yo3hjv/Yaesu_ATAS_120_Controller/BrdRev1.jpg

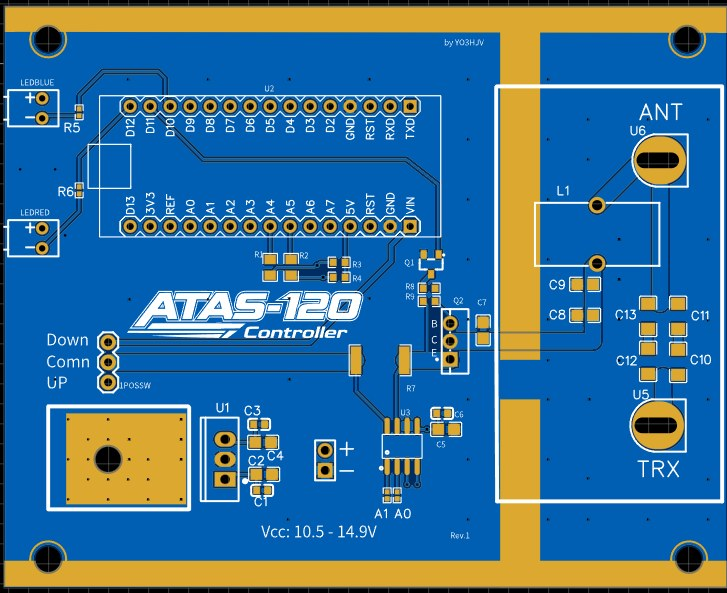
BrdRev1.jpg
