yo3hjv/Yaesu_ATAS_120_Controller/AtasController_bk.jpg

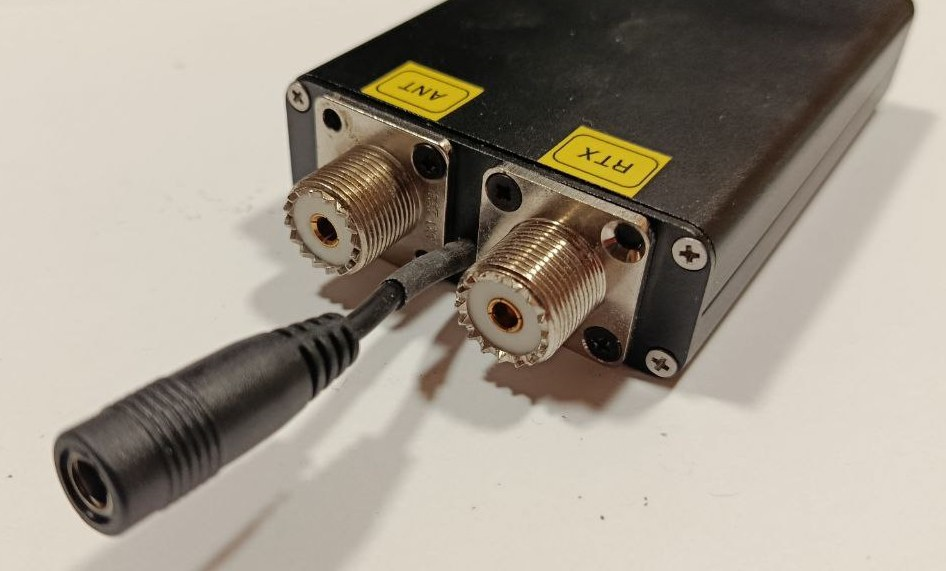
AtasController_bk.jpg
