yo3hjv/Yaesu_ATAS_120_Controller/AtasController_fr.jpg

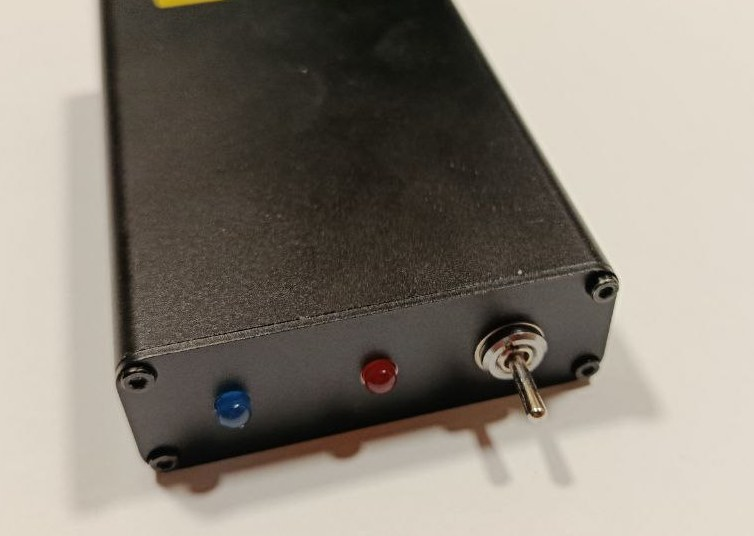
AtasController_fr.jpg
