yo3hjv/Yaesu_ATAS_120_Controller/Schematic_ATAS-120-Controller_2026-03-09.pdf

# U1 Input

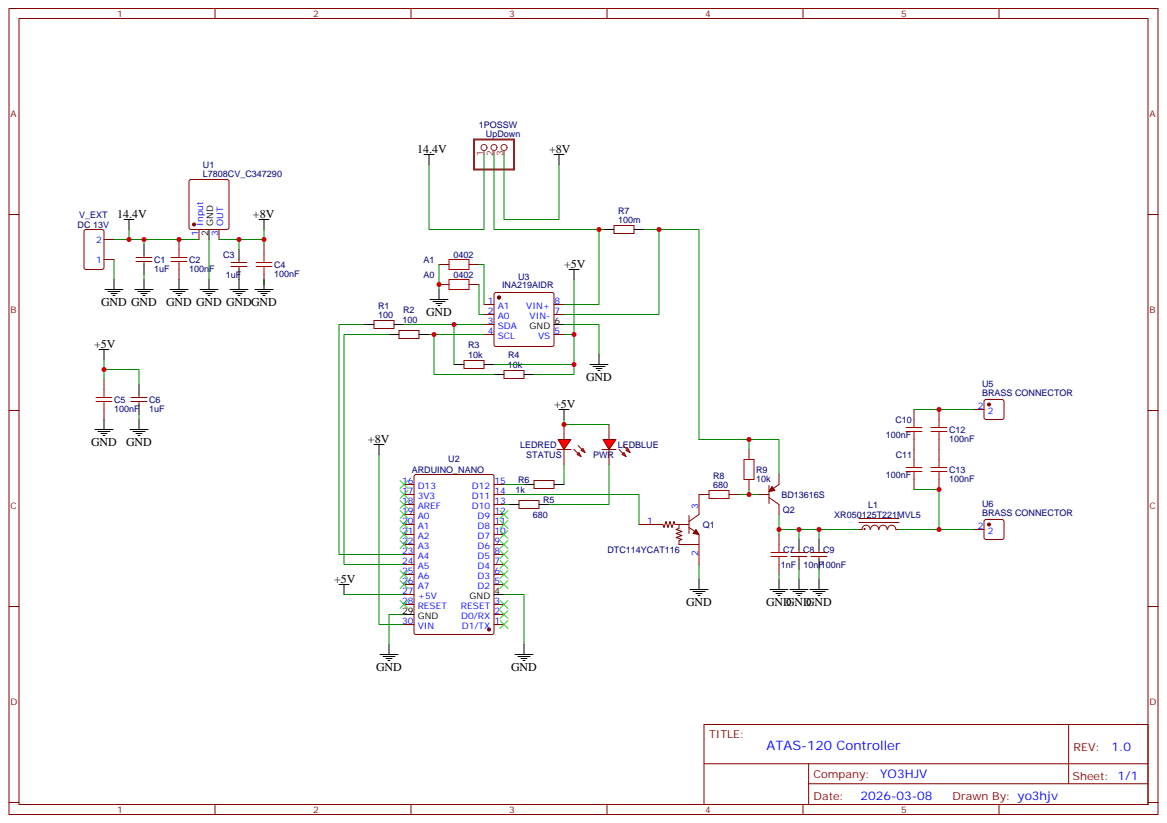
[picture p4: page 1]
